APRSFoundation/aprsappliance/README.md

# APRS Appliance

Welcome to the APRS Appliance repository - part of the official APRS Foundation organization on GitHub!
