APRSFoundation/aprsappliance/aprs-appliance-at-9600-baud-v0.1-20220619.pdf

# Using the APRS Appliance at 9600 Baud

## Don Rolph Ver 0.1 June 19, 2022

# The basic steps to reconfigure to 9600 baud

## 1. Set the radio to 9600 baud instead of 1200 baud: this is radio specific

## 2. Reconfigure the cable so that the 9600 baud receive signal is used by the radio interface card

## 3. Set the Raspberry PI systems for 9600 baud

### - Adjust the volume to increase the speaker output to 58 - Add the –X 64 argument to the Dire Wolf startup commend (usually in dw-start.sh) - Adjust direwolf.conf for MODEM 9600 and ARATE 96000

# Adjusting the radio to 9600 baud packet

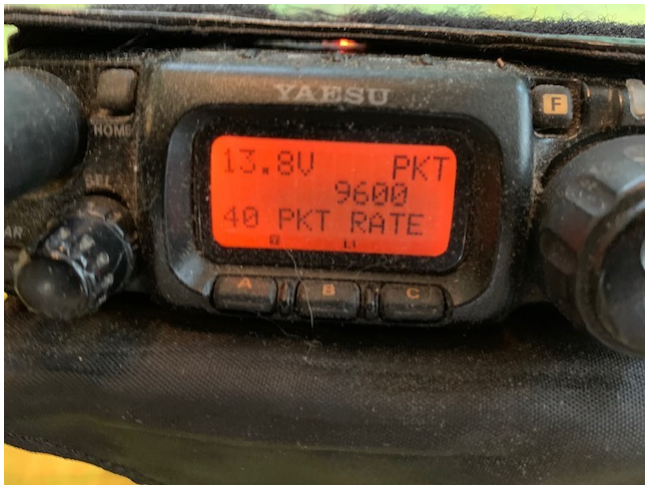
[picture p8: figure]

## On the FT-817ND this is menu item 40

# Set the cabling so the 9600 baud receive line feeds the radio interface board

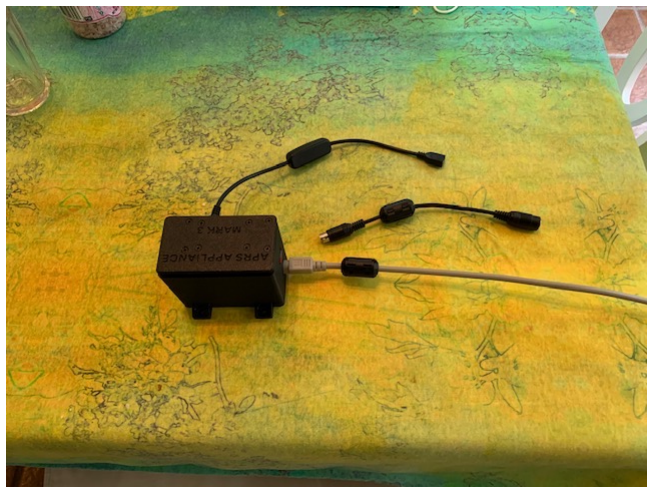
[picture p9: figure]

Unplug the radio 6 pin mini-din

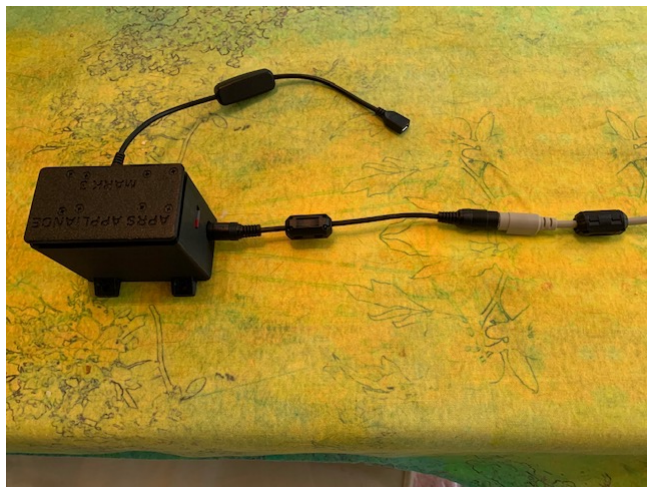
[picture p10: figure]

Cable from the APRS Appliance | Plug the Mobilinkd adapter cable (https://store.mobilinkd.com/products/minidin-6-1200-baud-adapter) into the APRS Appliance
| Plug the radio interface cable into the Mobilinkd adapter

For the APRS Appliance this is most easily accomplished using the Mobilinkd 1200-9600 baud adapter cable (https://store.mobilinkd.com/products/minidin-6-1200-baud-adapter)

# Adjust the speaker volume from the Interface to about 58

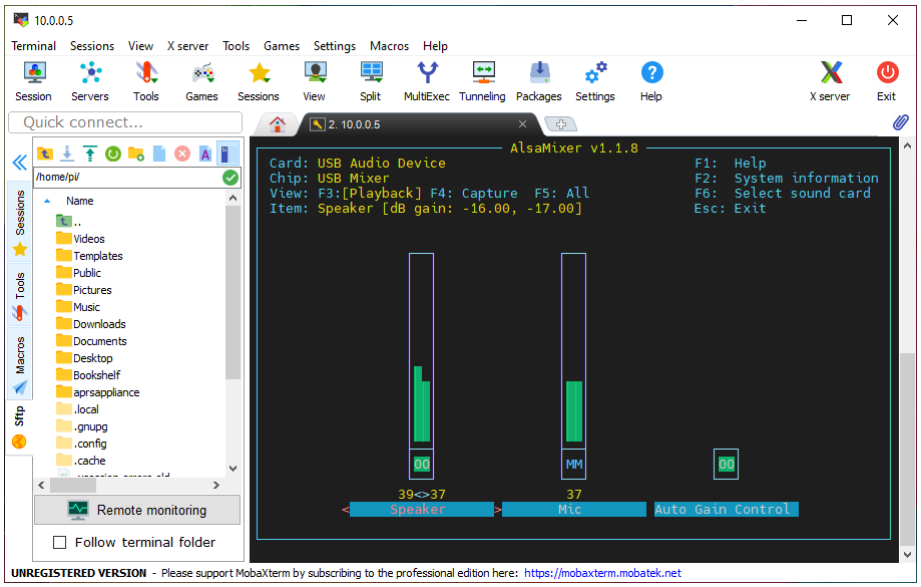
[picture p11: figure]

## Use alsamixer –c 1 and increase speaker volume to 58

# Add the –X 64 argument to direwolf startup

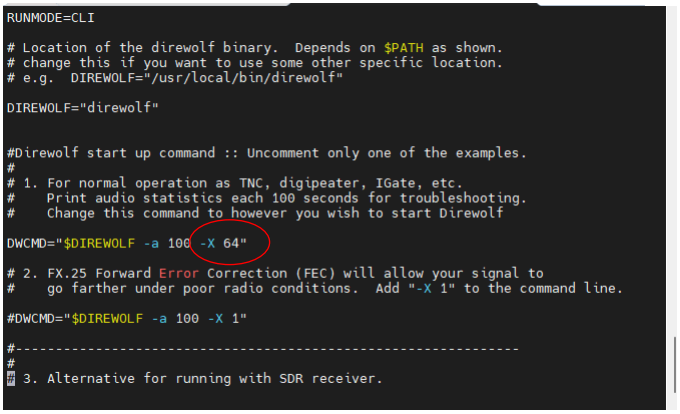
[picture p12: figure]

I typically use dw-start.sh to perform Dire Wolf startup But you can start with the direwolf command direwolf –t 0 –X 64

# Update direwolf.conf ARATE and MODEM

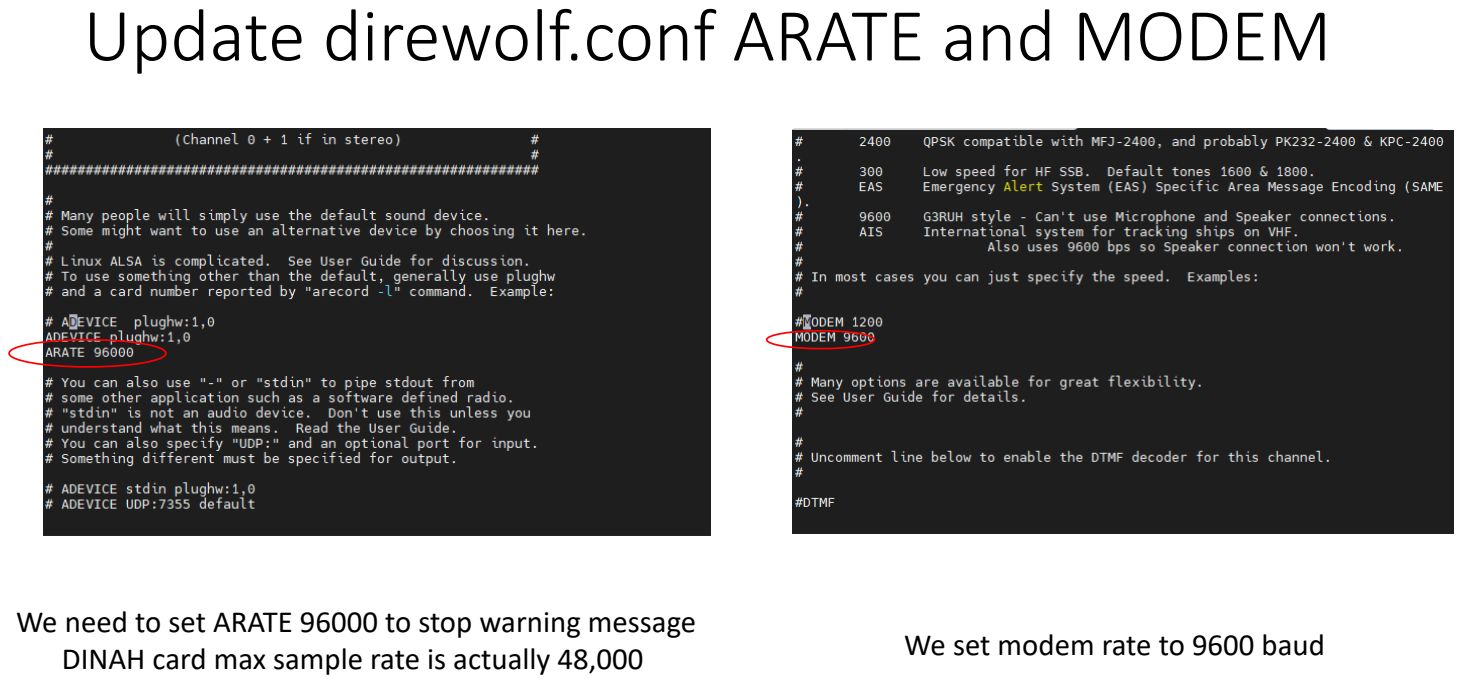
[picture p13: page 7]

We need to set ARATE 96000 to stop warning message
DINAH card max sample rate is actually 48,000 | We set modem rate to 9600 baud

# Now set a test APRS device at 9600 and test

## - For the D72A this is menu item 311, DATA SPEED

## - Set to 9600

## - I am having no trouble with D72A interoperating with APRS Appliance at 9600

baud.

## - I have having trouble with my D710A at 9600 baud
