APRSFoundation/aprsappliance/configs/allstar-based-build/mark2box-v1.stl

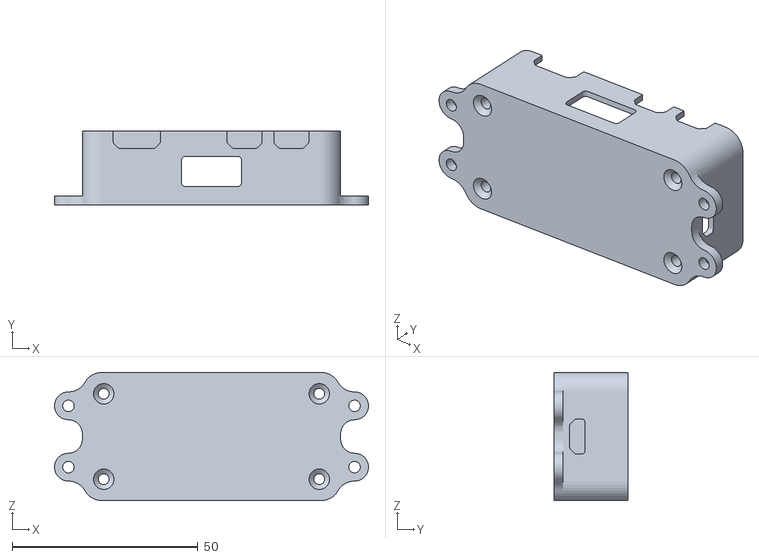
[picture p14: CAD file, 2023-10-02]
configs/allstar-based-build/mark2box-v1.stl
84.5 x 20.0 x 34.5
