APRSFoundation/aprsappliance/configs/allstar-based-build/mark2lid-v1.stl

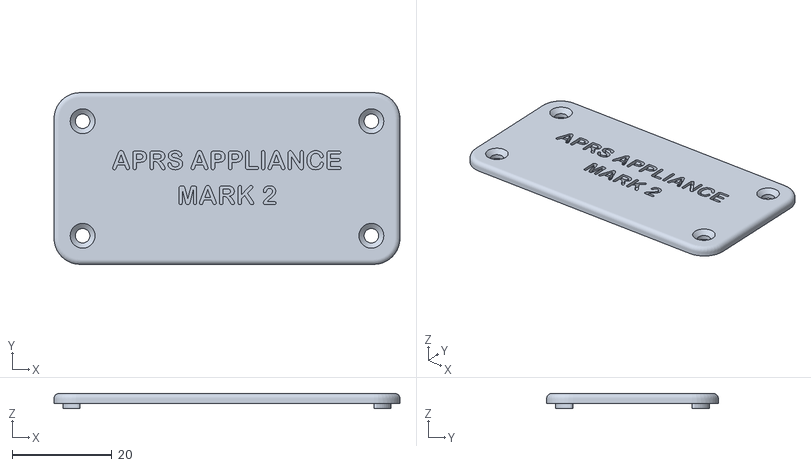
[picture p15: CAD file, 2023-10-02]
configs/allstar-based-build/mark2lid-v1.stl
69.5 x 34.5 x 3.00
