APRSFoundation/aprsappliance/configs/allstar-based-build/20220211-aprs-mark3-base.stl

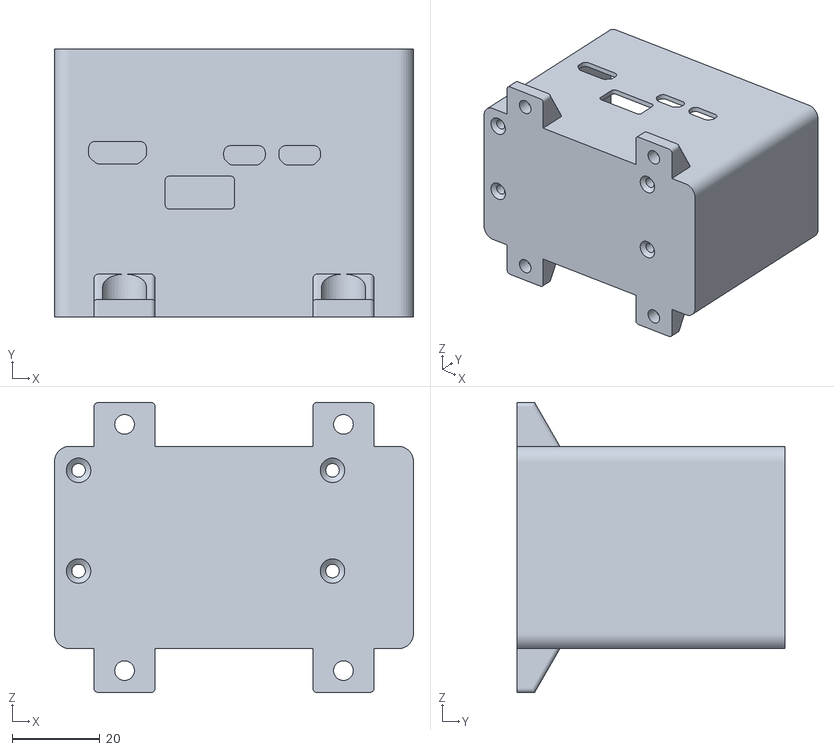
[picture p16: CAD file, 2023-10-02]
configs/allstar-based-build/20220211-aprs-mark3-base.stl
82.0 x 61.2 x 66.3
