APRSFoundation/aprsappliance/configs/allstar-based-build/20220211-aprs-mark3-cover.stl

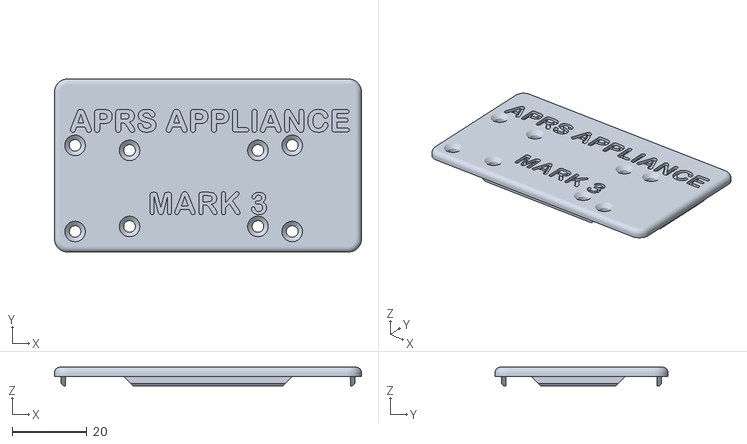
[picture p17: CAD file, 2023-10-02]
configs/allstar-based-build/20220211-aprs-mark3-cover.stl
82.0 x 46.2 x 5.00
